damienmaguire/CAN-BUS-Man-In-The-Middle/README.md

# CAN-BUS-Man-In-The-Middle
CAN BUS Man In The Middle for spying on and modifyling automotive can traffic on the fly.

Originally designed to allow use of a Tesla Gen 2 Battery charger in a gen 1 Nissan Leaf

Software in development.

Design files in DesignSpark PCB 9 format.

Untested as of release date.

21/03/20 : Software V1 uploaded. Built with ST CubeIDE. Hardware available from the Evbmw shop :
https://www.evbmw.com/index.php/evbmw-webshop/nissan-built-and-tested-boards/can-bus-man-in-the-middle
