damienmaguire/CAN-BUS-Man-In-The-Middle/CAN_MITM_V1_BOM_JLC.xls

Comment | Designator | Package | LCSC Part #
0.1UF | C1,C4,C5,C6,C7,C8,C9,C10,C12 | 0805_C | C49678
22PF | C2.C3 | 0805_C | C1804
RED LEDS | LED1,LED2,LED3 | CHIPLED_0805 | C84256
1KΩ | R1,R2,R5 | 0805_R | C17513
10KΩ | R6,R7 | 0805_R | C17414
120Ω | R3,R4 | 0805_R | C17437
SN65HVD234 | IC2,IC3 | SOIC-8_3.9x4.9x1.27P | C99818
SS54 | D1 | SMA,DO-214AC | C22452
STM32F105 | IC1 | STM32F105RBT6 | C8349
100UF 6.3V | C13,C14 | CASE-B_3528 | C16133
470uF 25V | C11 | SMD-ECAP-10x10 | C249931
8MHz | X1 | SMD-5032_2P | C115962
