damienmaguire/CAN-BUS-Man-In-The-Middle/(threads)

Thread 1 (2024-09-15):

Project old, when migrated to latest STM32CubeIDE, code is wiped out

bancroftd, 2024-09-15:
Any chance you could update the project. I have a board with STM32F105VCT6 chip using the pinout like here: https://dangerouspayload.com/wp-content/uploads/2020/03/can_bus_filter_schematics.png?w=1024. Its a mileage manipulator from BMW, and have a 25mhz crystal and 2 MCP2515. Any chance you could update the project for this chip?   :)
