damienmaguire/CAN-BUS-Man-In-The-Middle/CAN_MITM_V1 - Schematic.pdf

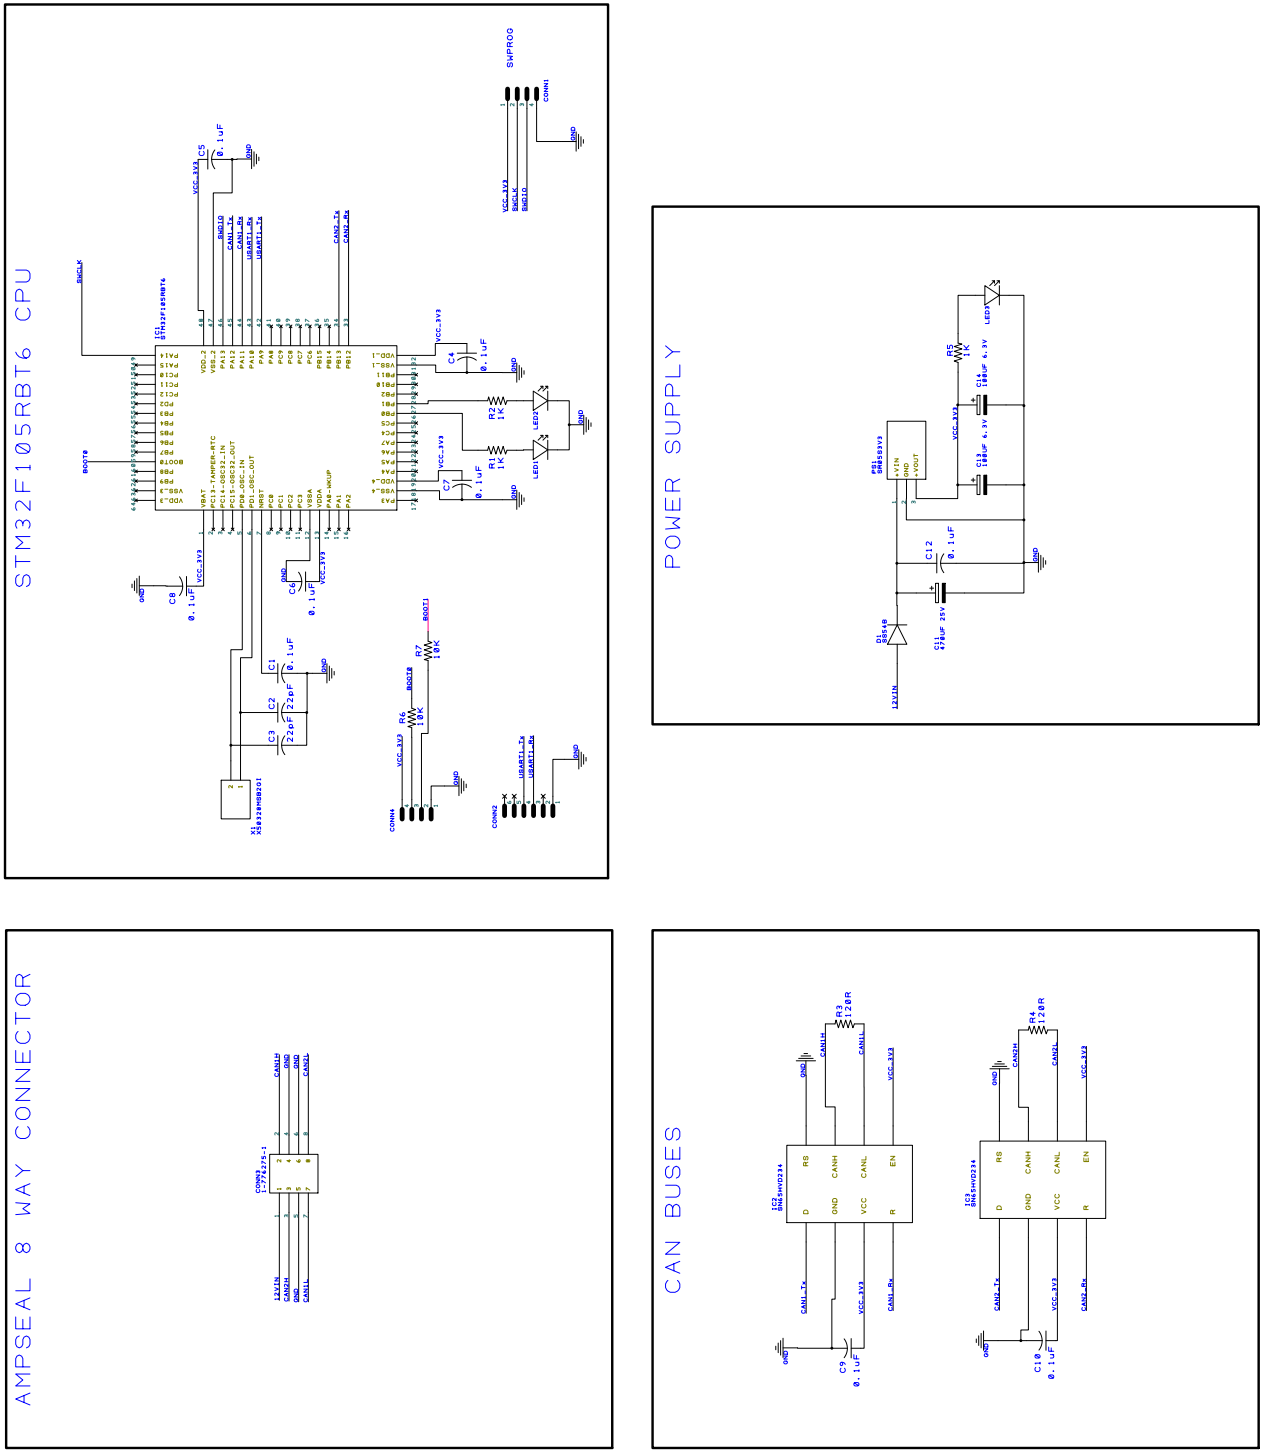
[picture p2: page 1]
