damienmaguire/CAN-BUS-Man-In-The-Middle/CAN_MITM_V1 - PCB.pdf

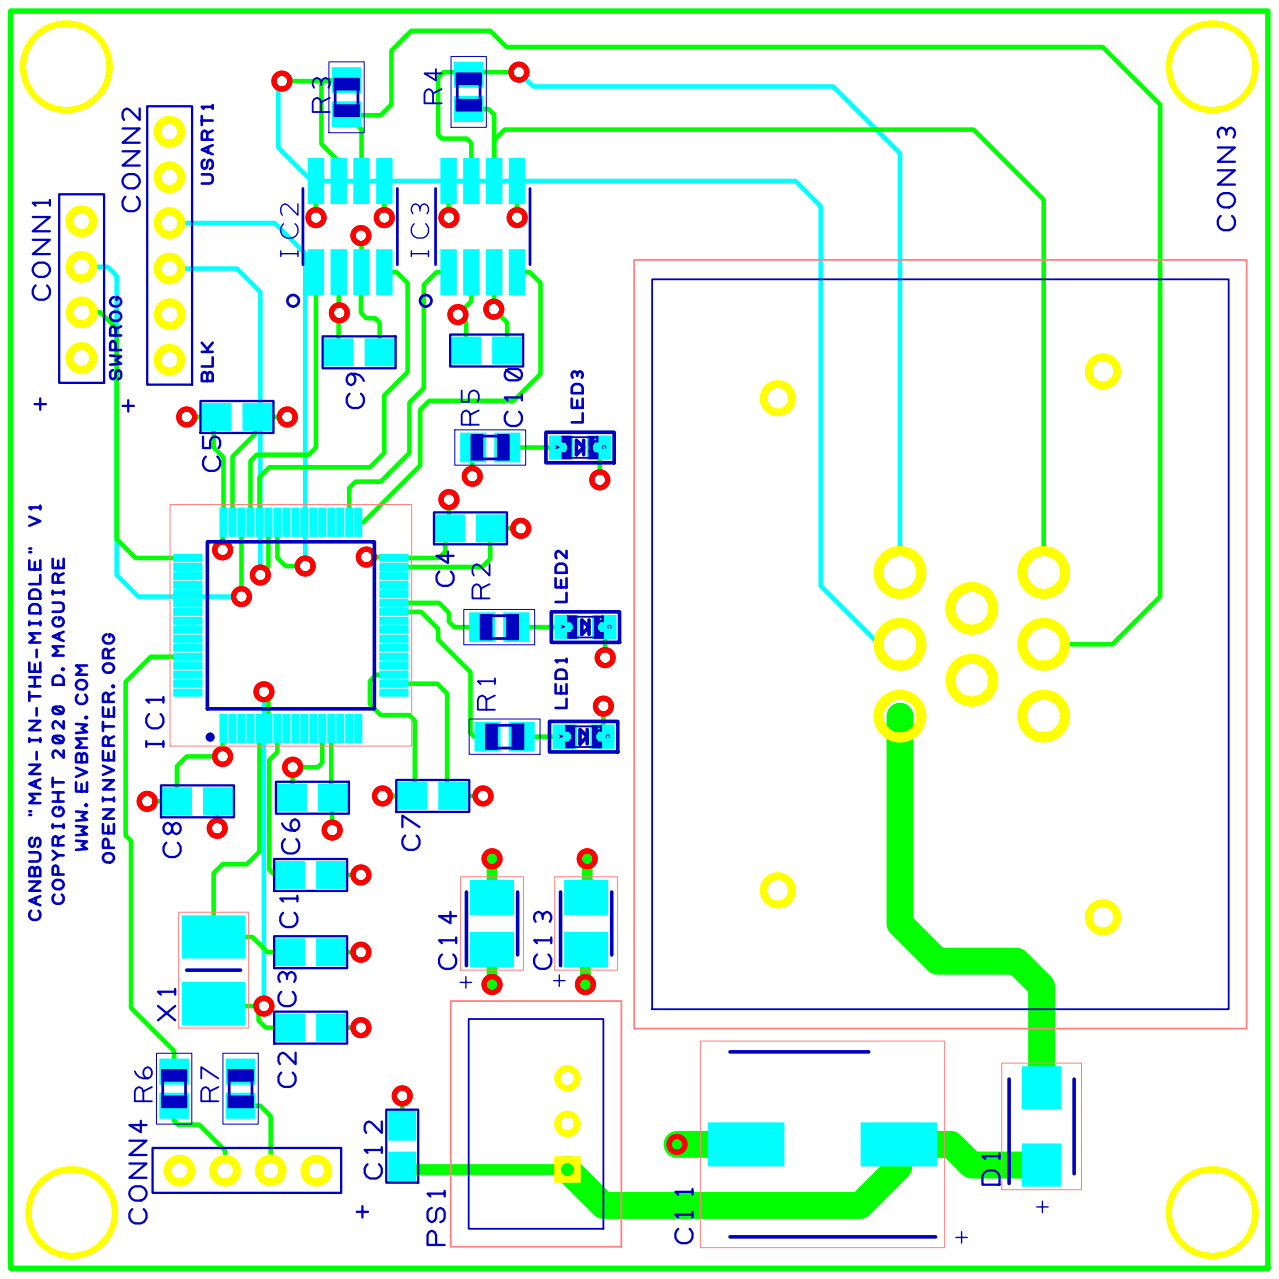
[picture p3: page 1]
