damienmaguire/CAN-BUS-Man-In-The-Middle/(list of files, drawings)

Other design files:
CAN_MITM_V1.pcb
