damienmaguire/CAN-BUS-Man-In-The-Middle/Software/Core/Inc/main.h

#define LED1_Pin GPIO_PIN_0
#define LED1_GPIO_Port GPIOB
#define LED2_Pin GPIO_PIN_1
#define LED2_GPIO_Port GPIOB
