damienmaguire/CAN-BUS-Man-In-The-Middle/(notices)

Notices in the files:
Software/Core/Inc/main.h:
© Copyright (c) 2020 STMicroelectronics.
All rights reserved.
